nanbuwks/ozone12864/README.md

# OZONE12864

ESP32 ozone meater with LCD JLX12864G-332-BN

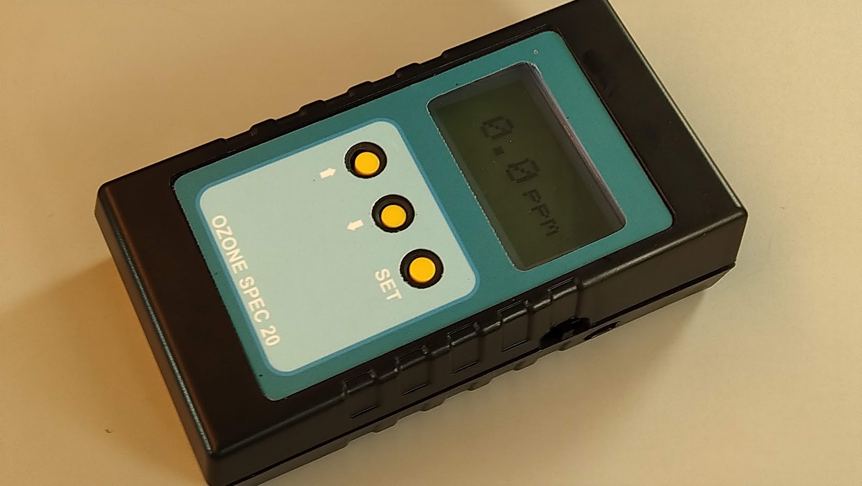
[picture p1: images/IMG_20210720_092740.jpg]


# sensor

SPEC electrochemical 3SP_O3_20 DIP 

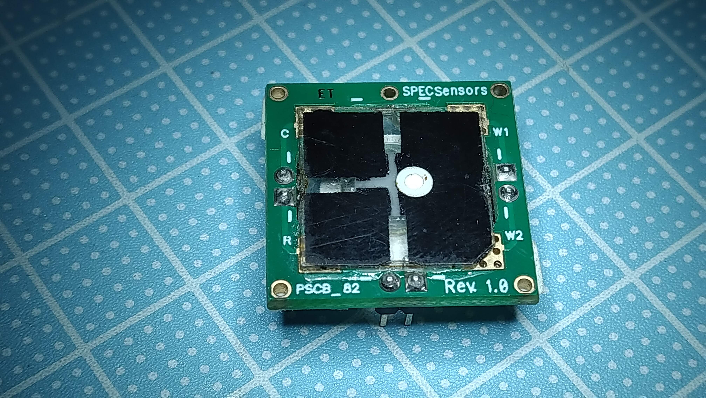
[picture p2: images/IMG_20200128_190550.jpg]


# principle

Potentiostat method. see:
https://qiita.com/nanbuwks/items/b0f3cb8982ab1c29c718
