nanbuwks/ozone12864/KiCad/ozone12864-bom.xlsx

Comment | Designator | Footprint | JLCPCB Part #（optional）
10u | C3,C7,C10 | C_0603_1608Metric | C18800
0.1u | C4,C5,C11 | C_0603_1608Metric | C14663
D_Schottky | D1,D2 | D_SOD-123 | C511865
LED | D3 | LED_D3.0mm | C779429
510k | R2,R3,R7,R6,R5,R4 | R_0603_1608Metric | C23192
10k | R1,R17,R12,R14,R9 | R_0603_1608Metric | C25804
75 | R15 | R_0603_1608Metric | C4275
ESP-WROOM-32 | U1 | ESP-WROOM-32 | C701342
Conn_01x13_Female | J11 | PinHeader_1x13_P2.54mm_Vertical | C2897376
270-1k | R16 | R_0603_1608Metric | C13167
10uF | C9 | C_0603_1608Metric | C18800
B | SW4 | SW_PUSH_6mm | C455098
OK | SW5 | SW_PUSH_6mm | C455098
A | SW3 | SW_PUSH_6mm | C455098
DCJACK | J1 | DCJACK | C16214
1k | R11,R13,R10,R8 | R_0603_1608Metric | C21190
IRF7317TRPBF | Q3 | SO-8_5.3x6.2mm_P1.27mm | C454608
20p | C6 | C_0603_1608Metric | C105621
