nanbuwks/ozone12864/KiCad/ozone12864_handsoldering_20210615_BOM.ods

Id | Designator | Package | Quantity | Designation | Supplier and ref
3 | BZ1 | MagneticBuzzer_ProSignal_ABI-010-RC | 1 | Buzzer
4 | C1,C2 | CP_Radial_D5.0mm_P2.00mm | 2 | CP 4.7uF
5 | C3 | C_0603_1608Metric | 1 | 10u
6 | C4,C5 | C_0603_1608Metric | 2 | 0.1u
7 | D2 | LED_D3.0mm | 1 | LED
8 | J1 | DCJACK | 1 | DCJACK
10 | J4 | PinSocket_1x08_P2.54mm_Vertical | 1 | Conn_01x08_Male
12 | R1,R2,R5 | R_0603_1608Metric | 3 | 510k
13 | R3 | R_0603_1608Metric | 1 | 10k
14 | R4 | R_0603_1608Metric | 1 | 330
15 | R27 | R_0603_1608Metric | 1 | 10k
16 | SW1 | SS-12F23_SLIDE_SWITCH | 1 | SW_SPDT
17 | SW3 | SW_TH_Tactile_Omron_B3F-4050 or 4-55 + A25 CAP | 1 | A
18 | SW4 | SW_TH_Tactile_Omron_B3F-4050 or 4-55 + A25 CAP | 1 | B
19 | SW5 | SW_TH_Tactile_Omron_B3F-4050 or 4-55 + A25 CAP | 1 | OK
20 | U1 | ESP-WROOM-32 | 1 | ESP-WROOM-32
21 | U2 | JLX12864G_128x64_2.11in_LCD_Module | 1 | JLX12864G-LCD
