nanbuwks/ozone12864/KiCad/ozone12864.kicad_pcb

## KiCad design KiCad/ozone12864.kicad_pcb (2024-02-08)

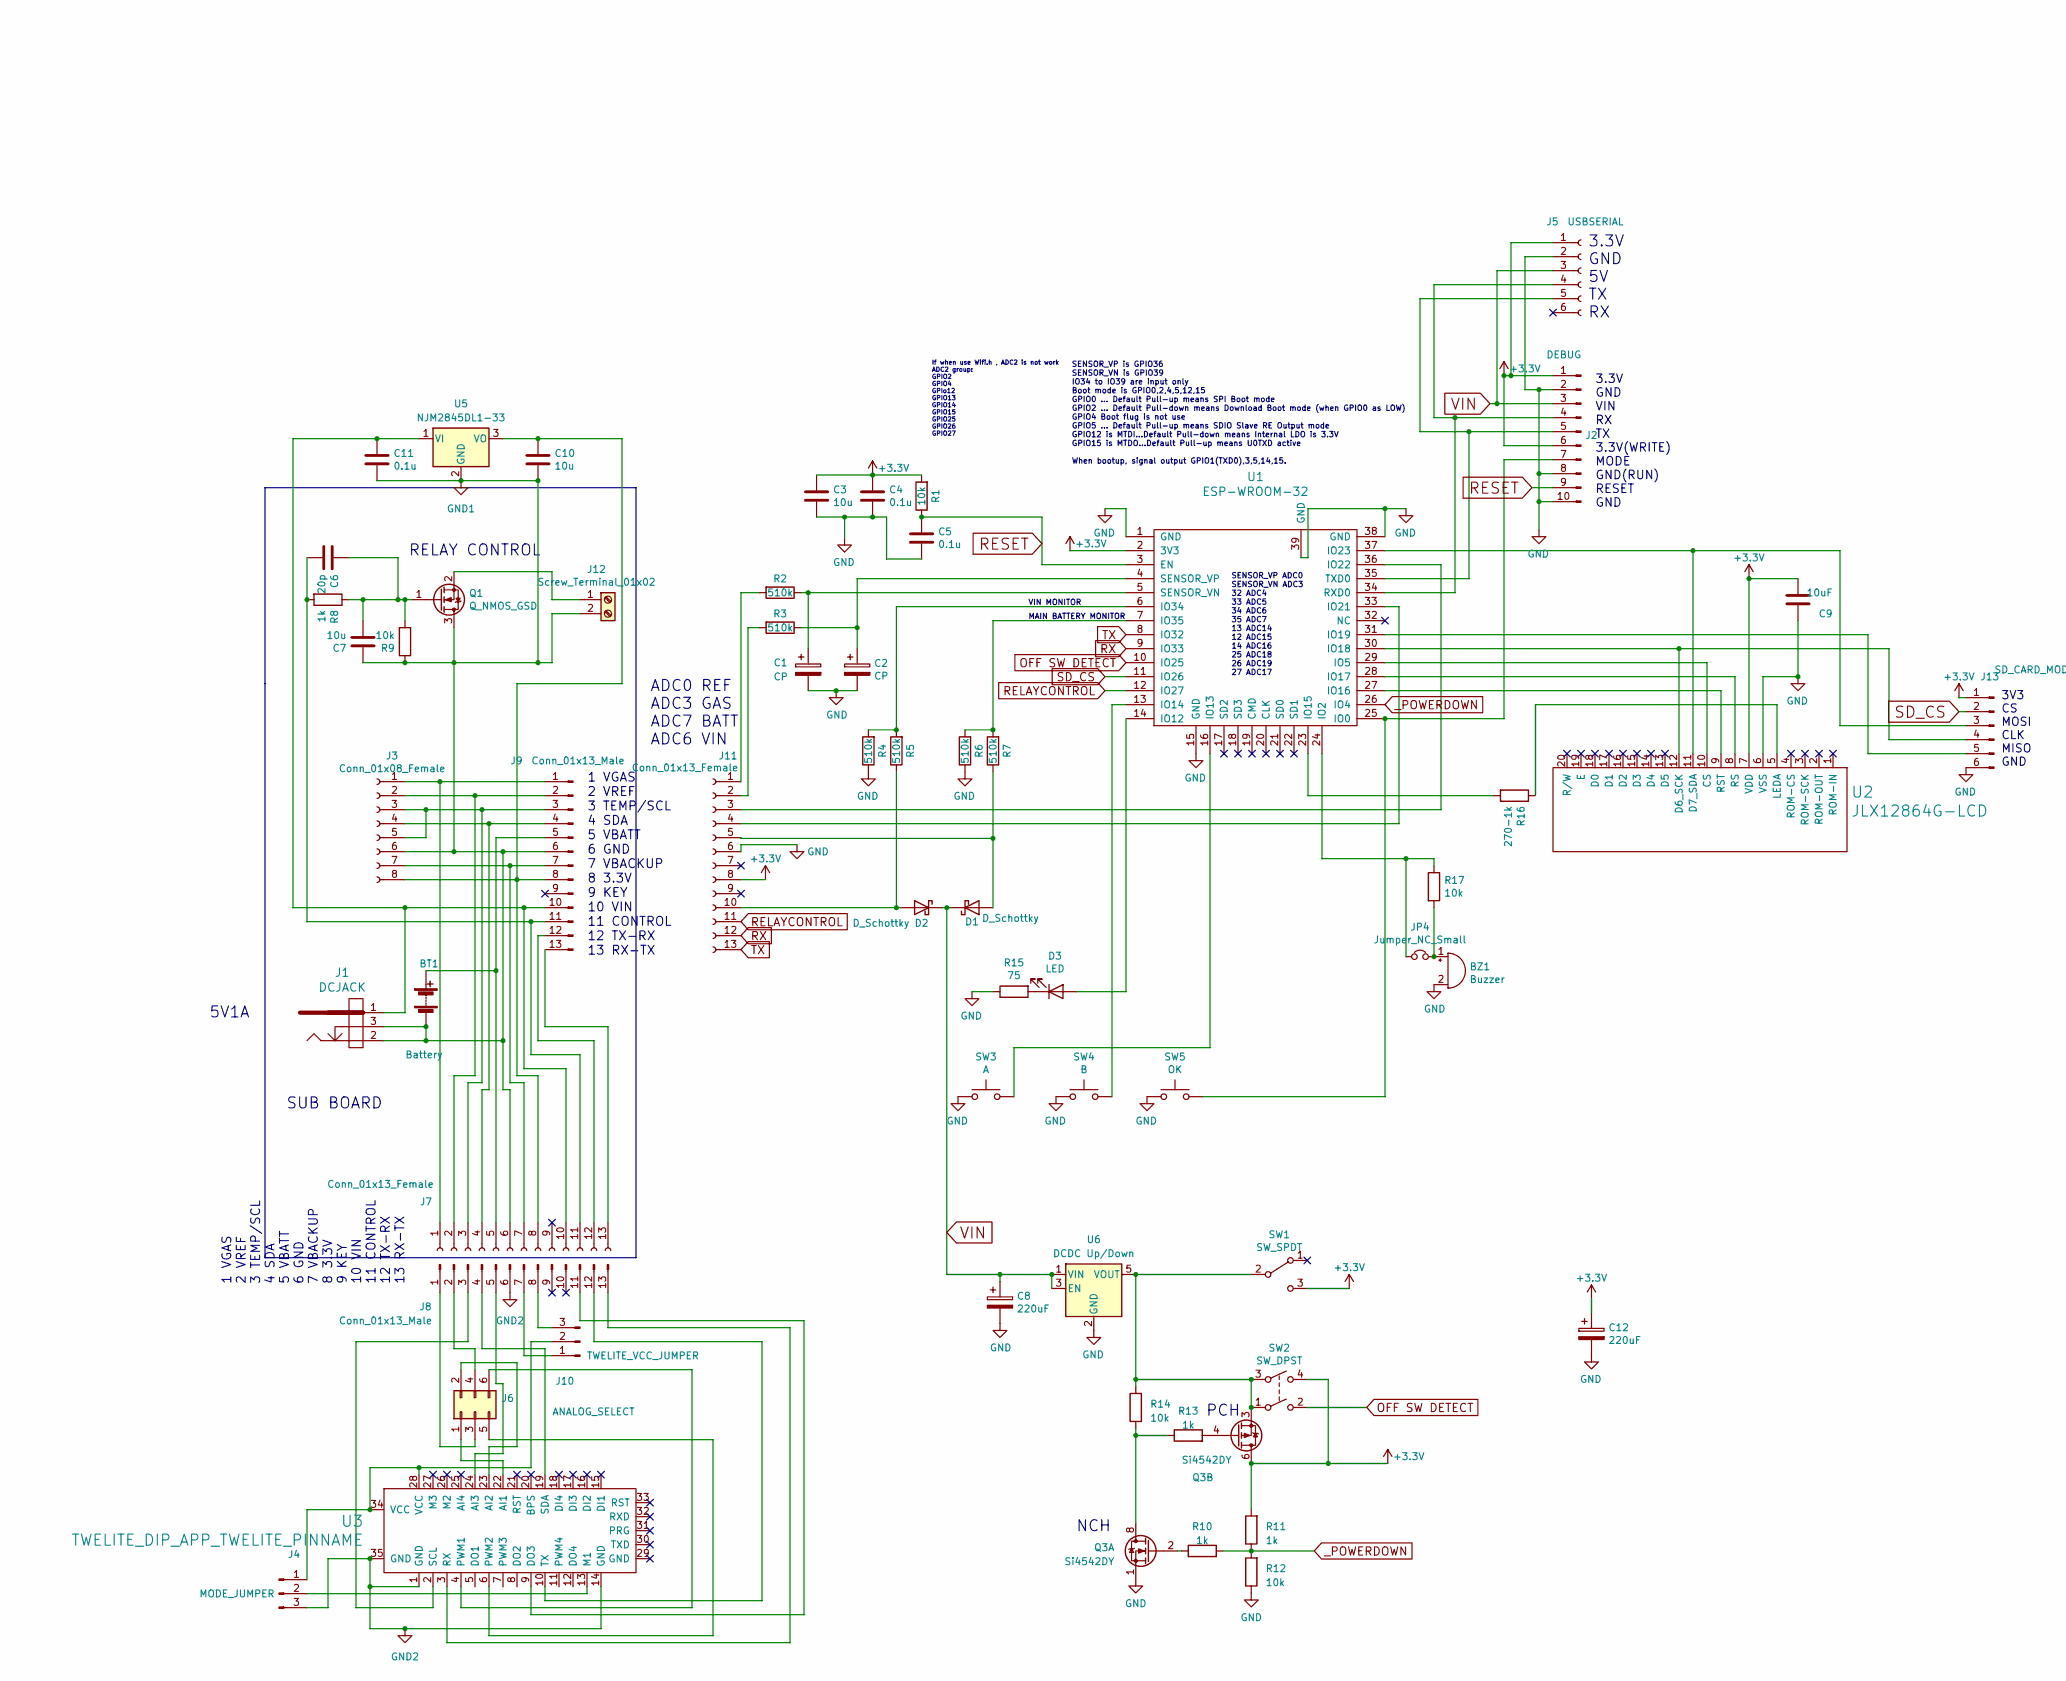
[picture p3: schematic ozone12864.kicad_sch, part in row 2, column 1]

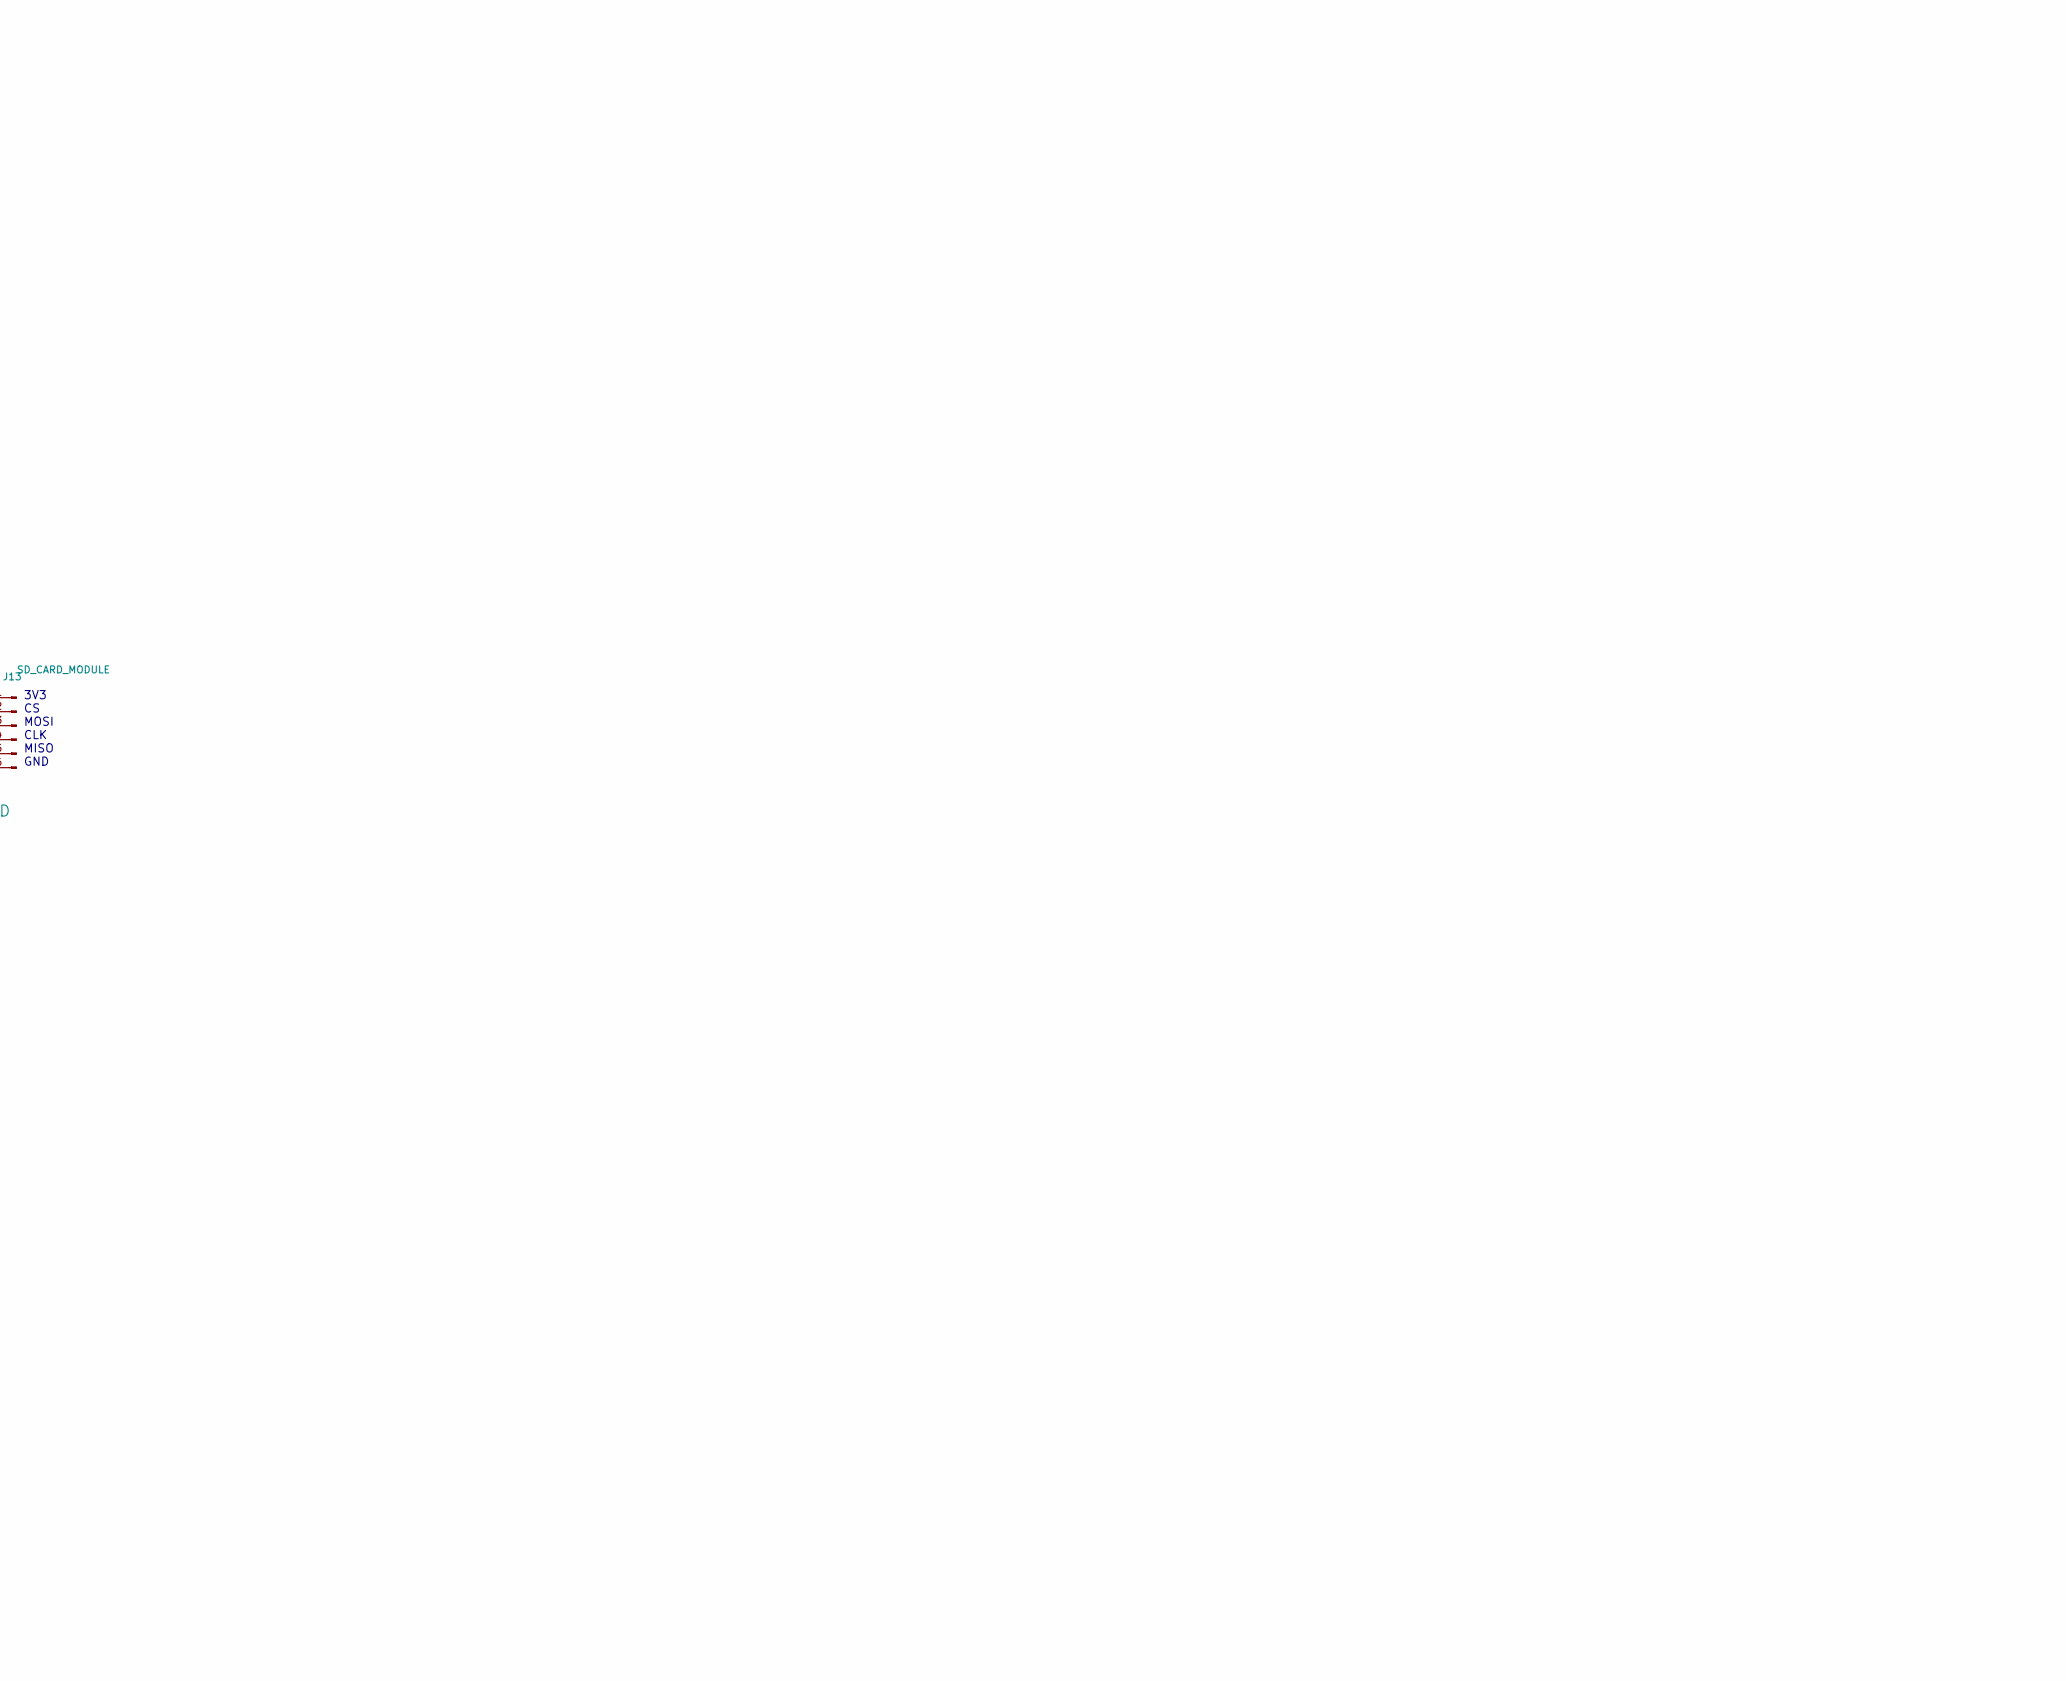
[picture p4: schematic ozone12864.kicad_sch, part in row 2, column 2]

Parts:
BT1: Battery; JST_XH_B2B-XH-AM_1x02_P2.50mm_Vertical
BZ1: Buzzer; MagneticBuzzer_ProSignal_ABI-010-RC
C1, C2: CP; CP_Radial_D5.0mm_P2.00mm
C3, C7, C10: 10u; C_0603_1608Metric
C4, C5, C11: 0.1u; C_0603_1608Metric
C6: 20p; C_0603_1608Metric
C8, C12: 220uF; CP_Radial_D5.0mm_P2.00mm
C9: 10uF; C_0603_1608Metric
D1, D2: D_Schottky; D_SOD-123
D3: LED; LED_D3.0mm
J1: DCJACK
J2: DEBUG; PinHeader_1x10_P2.54mm_Vertical
J3: Conn_01x08_Female; PinHeader_1x08_P2.54mm_Vertical
J4: MODE_JUMPER; PinHeader_1x03_P2.54mm_Vertical
J5: USBSERIAL; PinSocket_1x06_P2.54mm_Horizontal
J6: ANALOG_SELECT; PinHeader_2x03_P2.54mm_Vertical
J7, J11: Conn_01x13_Female; PinHeader_1x13_P2.54mm_Vertical
J8: Conn_01x13_Male; PinHeader_1x13_P2.54mm_Vertical
J9: Conn_01x13_Male; PinSocket_1x13_P2.54mm_Horizontal
J10: TWELITE_VCC_JUMPER; PinHeader_1x03_P2.54mm_Vertical
J12: Screw_Terminal_01x02; TerminalBlock_Phoenix_MKDS-1,5-2-5.08_1x02_P5.08mm_Horizont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
J13: SD_CARD_MODULE; PinHeader_1x06_P2.54mm_Vertical
JP4: Jumper_NC_Small; SolderJumper-2_P1.3mm_Bridged_RoundedPad1.0x1.5mm
Q1: Q_NMOS_GSD; TO-252-2
Q3: Si4542DY; SO-8_5.3x6.2mm_P1.27mm
R1, R9, R12, R14, R17: 10k; R_0603_1608Metric
R2, R3, R4, R5, R6, R7: 510k; R_0603_1608Metric
R8, R10, R11, R13: 1k; R_0603_1608Metric
R15: 75; R_0603_1608Metric
R16: 270-1k; R_0603_1608Metric
SW1: SW_SPDT; SS-12F23_SLIDE_SWITCH
SW2: SW_DPST; 5.8x5.8_7.0x7.0_8.5x8.5_SWITCH_EDGEMOUNT
SW3: A; SW_PUSH_6mm
SW4: B; SW_PUSH_6mm
SW5: OK; SW_PUSH_6mm
U1: ESP-WROOM-32
U2: JLX12864G-LCD; JLX12864G_128x64_2.11in_LCD_Module
U3: TWELITE_DIP_APP_TWELITE_PINNAME; TWE-LITE-DIP-PCB
U5: NJM2845DL1-33; TO-252-2
U6: DCDC Up/Down; TPS63020_Module_Both_Strawberrylinux_Taobao

Connections:
+3V3: C3.1, C4.1, C9.2, C12.1, J2.1, J2.6, J5.1, J11.8, J13.1, Q3.5 (D), Q3.6 (D), R1.2, R11.2, SW1.3 (C), SW2.4, U1.2 (3V3), U2.7 (VDD)
GND: BZ1.2 (+), C1.2, C2.2, C3.2, C4.2, C5.2, C8.2, C9.1, C12.2, J2.2, J2.8, J2.10, J5.2, J11.6, J13.6, Q3.1 (S), R4.1, R6.1, R12.1, R15.1, SW3.1, SW4.1, SW5.1, U1.1 (GND), U1.15 (GND), U1.38 (GND), U1.39 (GND), U2.6 (VSS), U6.2 (GND)
GND1: BT1.2 (-), C7.1, C10.2, C11.2, J1.2, J1.3, J3.6, J7.6, J9.6, J12.2, Q1.3 (D), R9.1, U5.2 (GND)
unnamed: BT1.1 (+), J7.5, J9.5
unnamed: BZ1.1 (-), JP4.2, R17.2
unnamed: D1.2 (A), J11.5, R7.1
unnamed: D2.2 (A), J11.10, R5.1
unnamed: D3.2 (A), U1.14 (IO12)
unnamed: D3.1 (K), R15.2
unnamed: J2.4, J5.4, U1.34 (RXD0)
unnamed: J2.5, J5.5, U1.35 (TXD0)
unnamed: J2.7, SW5.2, U1.25 (IO0)
unnamed: J3.1, J7.1, J9.1
unnamed: J3.2, J7.2, J9.2
unnamed: J3.3, J3.5, J7.3, J9.3
unnamed: J3.4, J7.4, J9.4
unnamed: J3.7, J7.7, J9.7
unnamed: C10.1, J3.8, J7.8, J9.8, U5.3 (VO)
unnamed: J4.2, U3.13 (M1)
unnamed: J4.3, J8.6, U3.1 (GND), U3.14 (GND), U3.35 (GND)
unnamed: J6.1, U3.22 (AI1)
unnamed: J6.2, U3.23 (AI2)
unnamed: J6.3, J8.1
unnamed: J6.4, J8.2
unnamed: J6.5, U3.6 (PWM2)
unnamed: J6.6, U3.4 (PWM1)
unnamed: C11.1, J1.1, J7.10, J9.10, U5.1 (VI)
unnamed: C6.2, J7.11, J9.11, R8.2
unnamed: J7.12, J9.12
unnamed: J7.13, J9.13
unnamed: J8.3, U3.2 (SCL)
unnamed: J8.4, U3.19 (SDA)
unnamed: J8.5, U3.24 (AI3)
unnamed: J8.11, U3.9 (DO3)
unnamed: J8.12, U3.10 (TX)
unnamed: J8.13, U3.3 (RX)
unnamed: J8.7, J10.1
unnamed: J4.1, J10.2, U3.28 (VCC), U3.34 (VCC)
unnamed: J8.8, J10.3
unnamed: J11.1, R2.2
unnamed: J11.2, R3.2
unnamed: J11.3, U1.36 (IO22)
unnamed: J11.4, U1.33 (IO21)
unnamed: J12.1, Q1.2 (S)
unnamed: J13.3, U1.37 (IO23), U2.11 (D7_SDA)
unnamed: J13.4, U1.30 (IO18), U2.12 (D6_SCK)
unnamed: J13.5, U1.31 (IO19)
unnamed: C6.1, C7.2, Q1.1 (G), R8.1, R9.2
unnamed: Q3.7 (D), Q3.8 (D), R13.1, R14.1
unnamed: Q3.2 (G), R10.1
unnamed: Q3.3 (1), R14.2, SW1.2 (B), SW2.1, SW2.3, U6.5 (VOUT)
unnamed: Q3.4 (G), R13.2
unnamed: JP4.1, R17.1, U1.24 (IO2)
unnamed: U1.29 (IO5), U2.10 (CS)
unnamed: SW3.2, U1.16 (IO13)
unnamed: SW4.2, U1.13 (IO14)
unnamed: R16.2, U1.23 (IO15)
unnamed: U1.27 (IO16), U2.9 (RST)
unnamed: U1.28 (IO17), U2.8 (RS)
unnamed: R4.2, R5.2, U1.6 (IO34)
unnamed: R6.2, R7.2, U1.7 (IO35)
unnamed: C1.1, R2.1, U1.5 (SENSOR_VN)
unnamed: C2.1, R3.1, U1.4 (SENSOR_VP)
unnamed: R16.1, U2.5 (LEDA)
OFF SW DETECT: SW2.2, U1.10 (IO25)
RELAYCONTROL: J11.11, U1.12 (IO27)
RESET: C5.1, J2.9, R1.1, U1.3 (EN)
RX: J11.12, U1.9 (IO33)
SD_CS: J13.2, U1.11 (IO26)
TX: J11.13, U1.8 (IO32)
VIN: C8.1, D1.1 (K), D2.1 (K), J2.3, J5.3, U6.1 (VIN), U6.3 (EN)
_POWERDOWN: R10.2, R11.1, R12.2, U1.26 (IO4)

Notes on the sheet:
ADC0 REF ADC3 GAS ADC7 BATT ADC6 VIN
3.3V GND VIN RX TX 3.3V(WRITE) MODE GND(RUN) RESET GND
PCH
If when use Wifi.h , ADC2 is not work ADC2 group: GPIO2 GPIO4 GPIo12 GPIO13 GPIO14 GPIO15 GPIO25 GPIO26 GPIO27
SUB BOARD
SENSOR_VP is GPIO36 SENSOR_VN is GPIO39 IO34 to IO39 are input only Boot mode is GPIO0,2,4,5,12,15 GPIO0 ... Default Pull-up means SPI Boot mode GPIO2 ... Default Pull-down means Download Boot mode (when GPIO0 as LOW) GPIO4 Boot flug is not use GPIO5 ... Default Pull-up means SDIO Slave RE Output m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
RELAY CONTROL
3.3V GND 5V TX RX
MAIN BATTERY MONITOR
1 VGAS 2 VREF 3 TEMP/SCL 4 SDA 5 VBATT 6 GND 7 VBACKUP 8 3.3V 9 KEY 10 VIN 11 CONTROL 12 TX-RX 13 RX-TX
VIN MONITOR
NCH
5V1A
SENSOR_VP ADC0 SENSOR_VN ADC3 32 ADC4 33 ADC5 34 ADC6 35 ADC7 13 ADC14 12 ADC15 14 ADC16 25 ADC18 26 ADC19 27 ADC17
3V3 CS MOSI CLK MISO GND

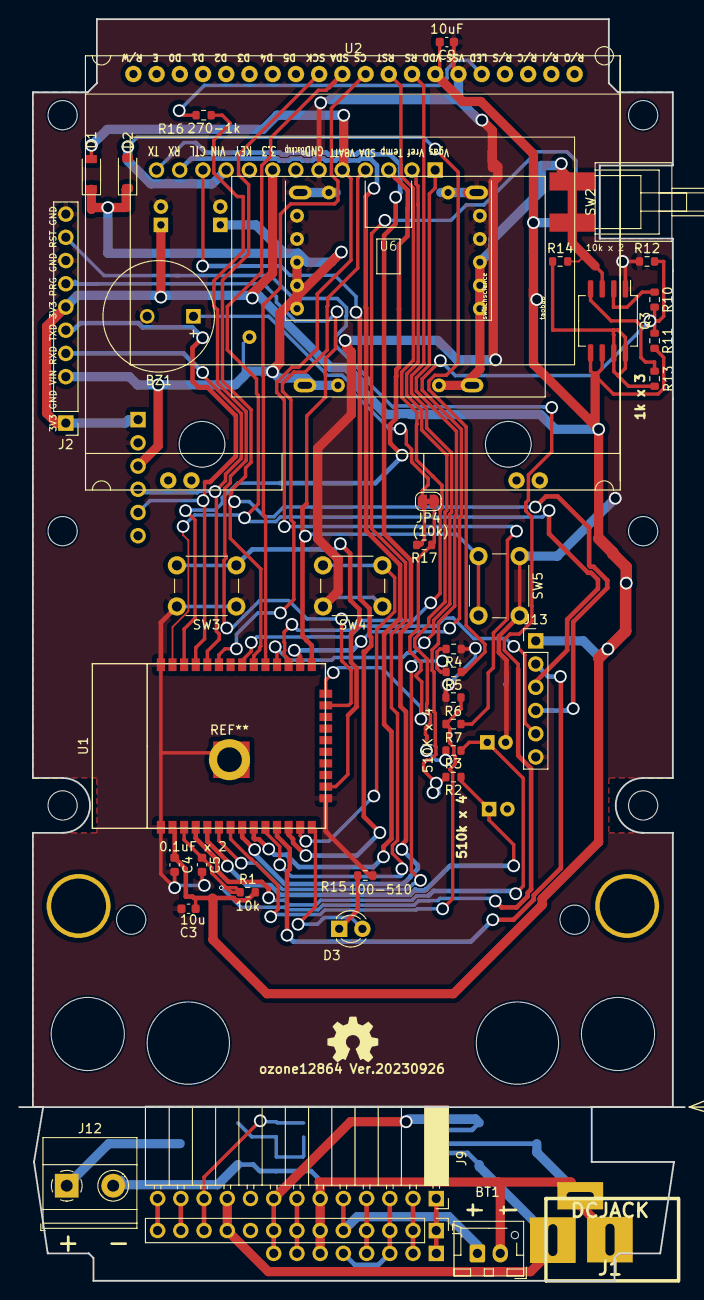
[picture p5: board ozone12864.kicad_pcb from above]

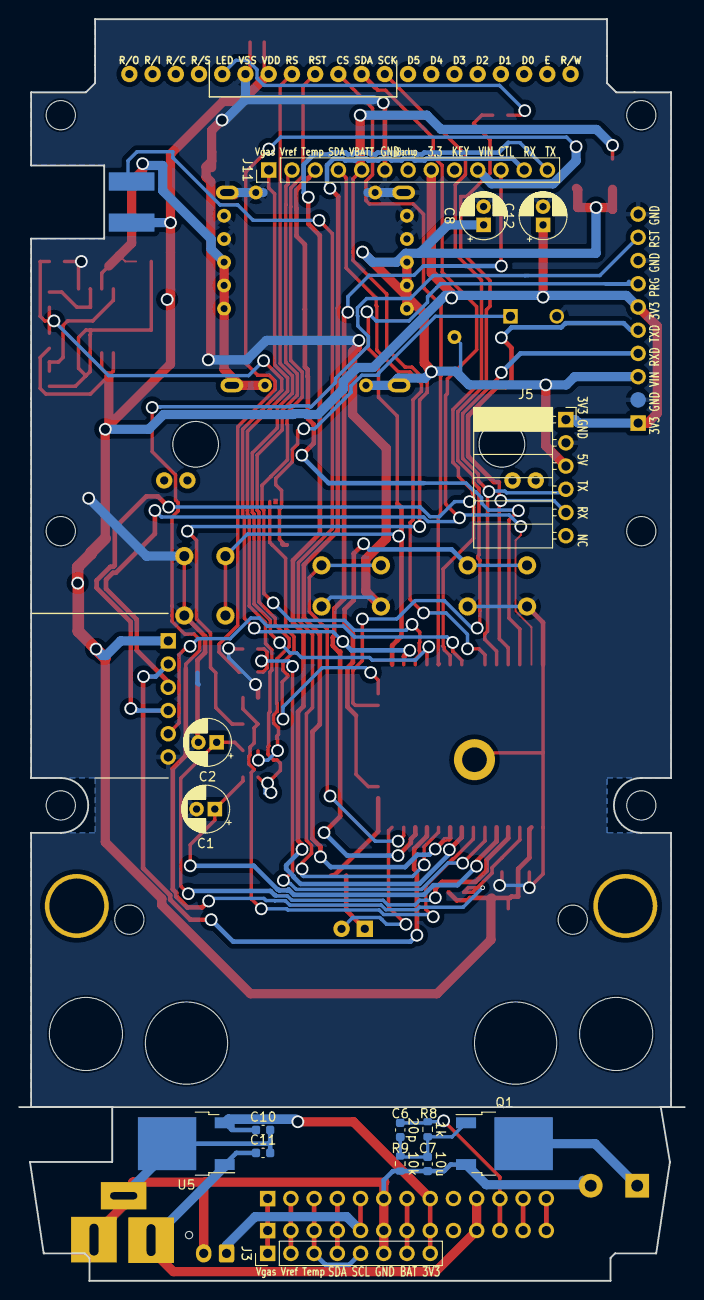
[picture p6: board ozone12864.kicad_pcb from below]

Board: 2 copper layers, 72.8 x 138.0 mm, 55 parts (15 on the bottom side), 55 nets.

Other parts of the board:
OSHW: 1.1; OSHW_LOGL_SYLK_5mm
