nanbuwks/ozone12864/(commit log)

2023-07-29 update to ver.202307 version
    [ozone12864.kicad_pcb]
2023-07-29 update schematic
    [ozone12864.kicad_sch]
2023-08-25 fix pcb bug / add arduino sketch
    [ozone12864-B_Cu.gbr, ozone12864-B_Mask.gbr, ozone12864-B_Silkscreen.gbr, ozone12864-Edge_Cuts.gbr, ozone12864-F_Cu.gbr, ozone12864-F_Mask.gbr, ozone12864-F_Silkscreen.gbr, ozone12864-NPTH.drl]
2023-09-26 PCB pattern bug fix
    [ozone12864-B_Cu.gbr, ozone12864-B_Mask.gbr, ozone12864-B_Silkscreen.gbr, ozone12864-Edge_Cuts.gbr, ozone12864-F_Cu.gbr, ozone12864-F_Mask.gbr, ozone12864-F_Silkscreen.gbr, ozone12864-NPTH.drl]
2024-02-08 LovyanGFX test
    [ozone12864-B_Cu.gbr, ozone12864-B_Mask.gbr, ozone12864-B_Silkscreen.gbr, ozone12864-Edge_Cuts.gbr, ozone12864-F_Cu.gbr, ozone12864-F_Mask.gbr, ozone12864-F_Silkscreen.gbr, ozone12864-NPTH.drl]
2024-02-08 update arduino sketch
2024-02-22 add paramater save in arduino sketch
2024-02-22 make menu arduino sketch
2024-08-29 arduino sketch update for value display at web browser
